jaypeeds/hamon-cam-1953/STL/bouchon.stl

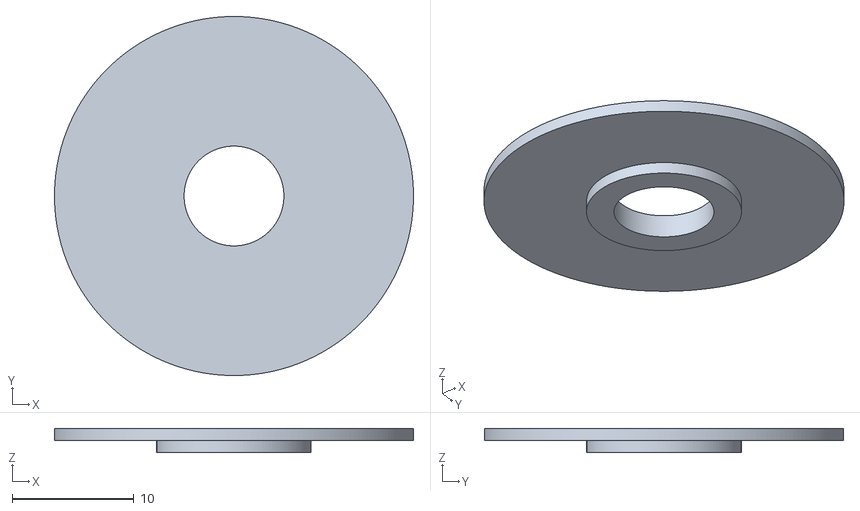
[picture p7: CAD file, 2019-05-12]
STL/bouchon.stl
29.5 x 29.5 x 2.00
