jaypeeds/hamon-cam-1953/STL/capot.stl

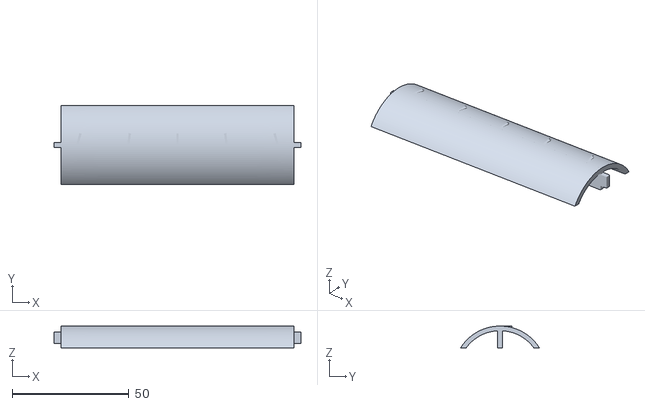
[picture p8: CAD file, 2019-05-12]
STL/capot.stl
106.0 x 33.9 x 9.39
