jaypeeds/hamon-cam-1953/STL/bras.stl

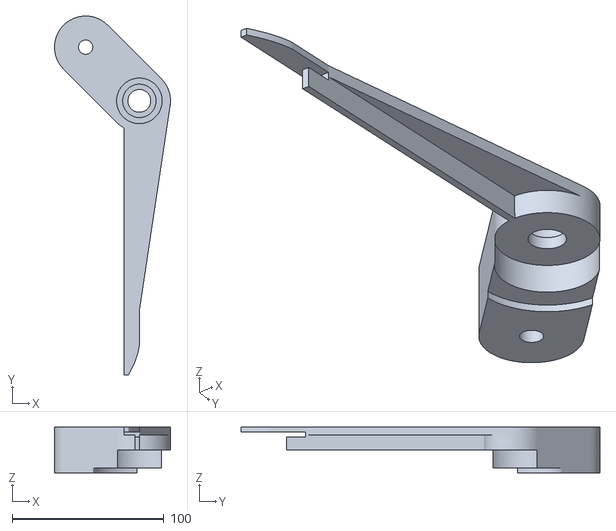
[picture p9: CAD file, 2019-05-12]
STL/bras.stl
76.4 x 236.3 x 30.0
