jaypeeds/hamon-cam-1953/STL/palier.stl

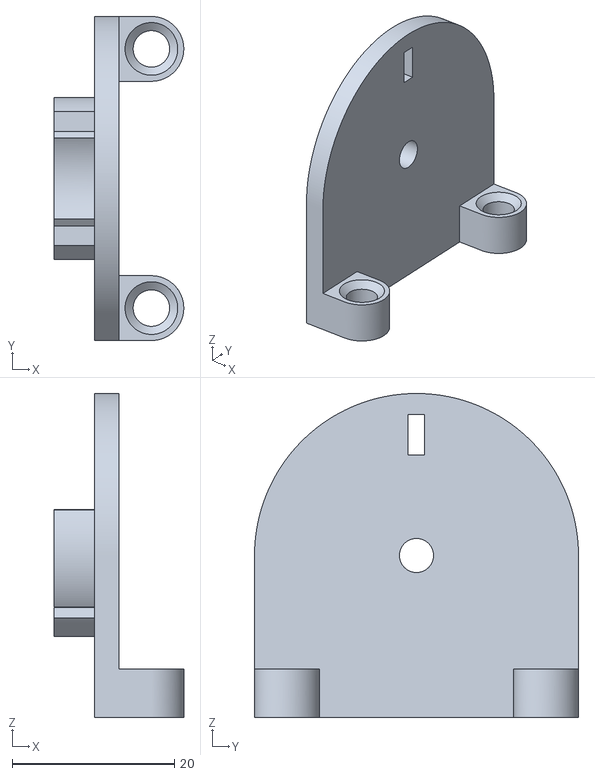
[picture p10: CAD file, 2019-05-12]
STL/palier.stl
16.0 x 40.0 x 40.0
