jaypeeds/hamon-cam-1953/STL/rail.stl

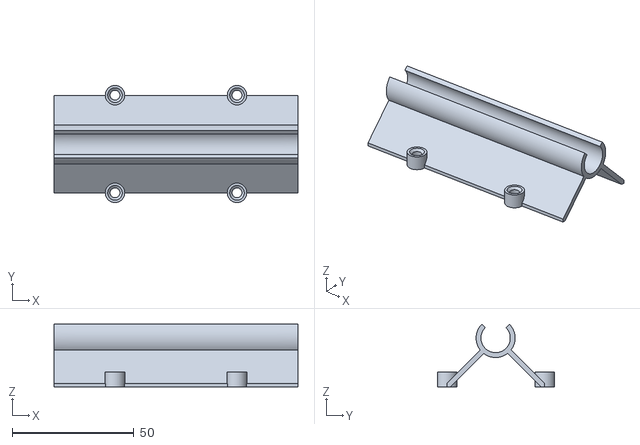
[picture p11: CAD file, 2019-05-12]
STL/rail.stl
100.0 x 48.0 x 25.7
