jaypeeds/hamon-cam-1953/STL/came.stl

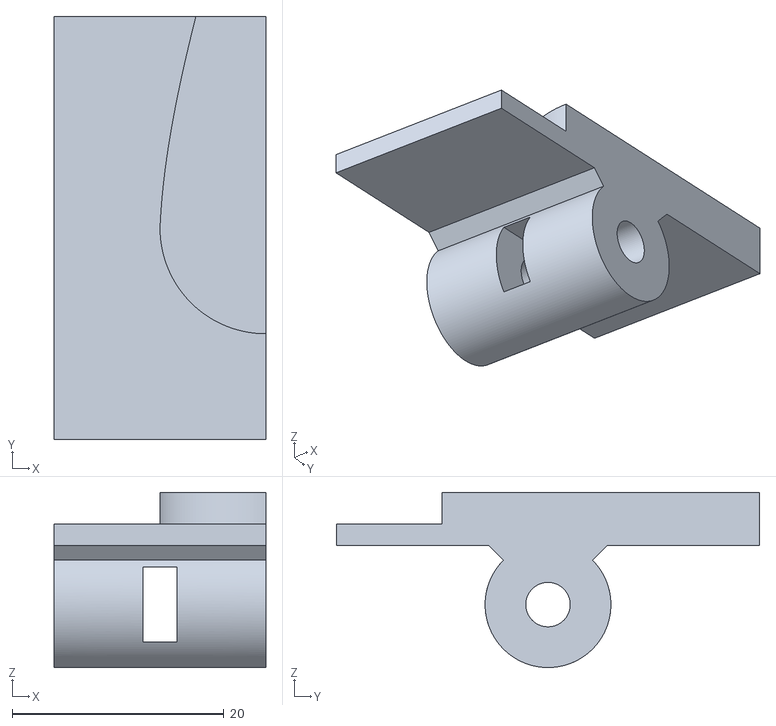
[picture p12: CAD file, 2019-05-12]
STL/came.stl
20.0 x 40.0 x 16.6
