jaypeeds/hamon-cam-1953/STL/embase-axe.stl

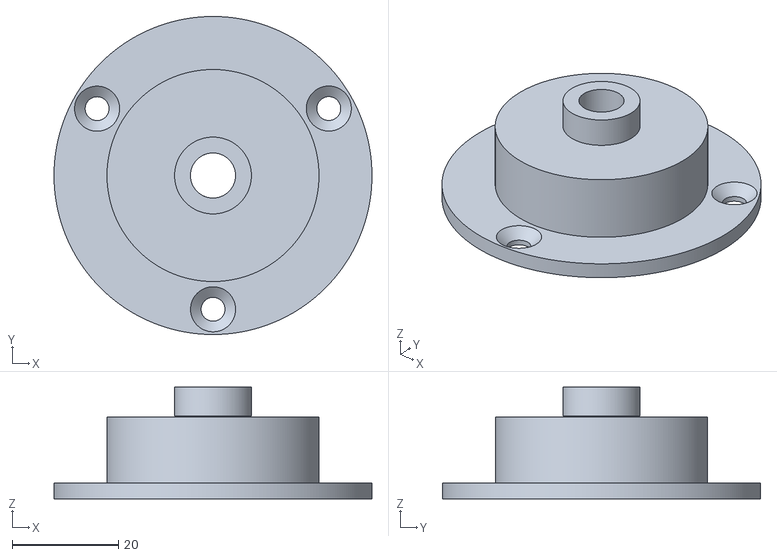
[picture p13: CAD file, 2019-05-12]
STL/embase-axe.stl
60.0 x 60.0 x 21.1
