jaypeeds/hamon-cam-1953/STL/support-moteur.stl

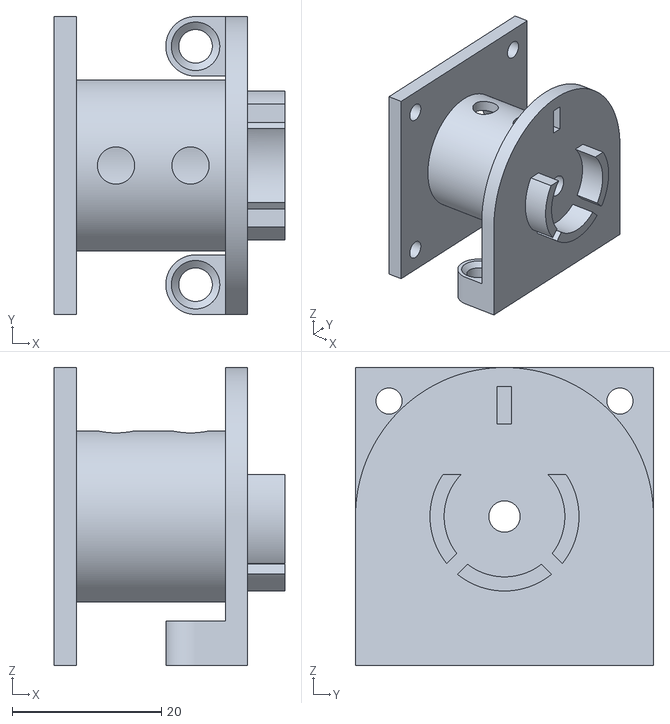
[picture p14: CAD file, 2019-05-12]
STL/support-moteur.stl
31.0 x 40.0 x 40.0
