jaypeeds/hamon-cam-1953/images/assembly and sketches.png

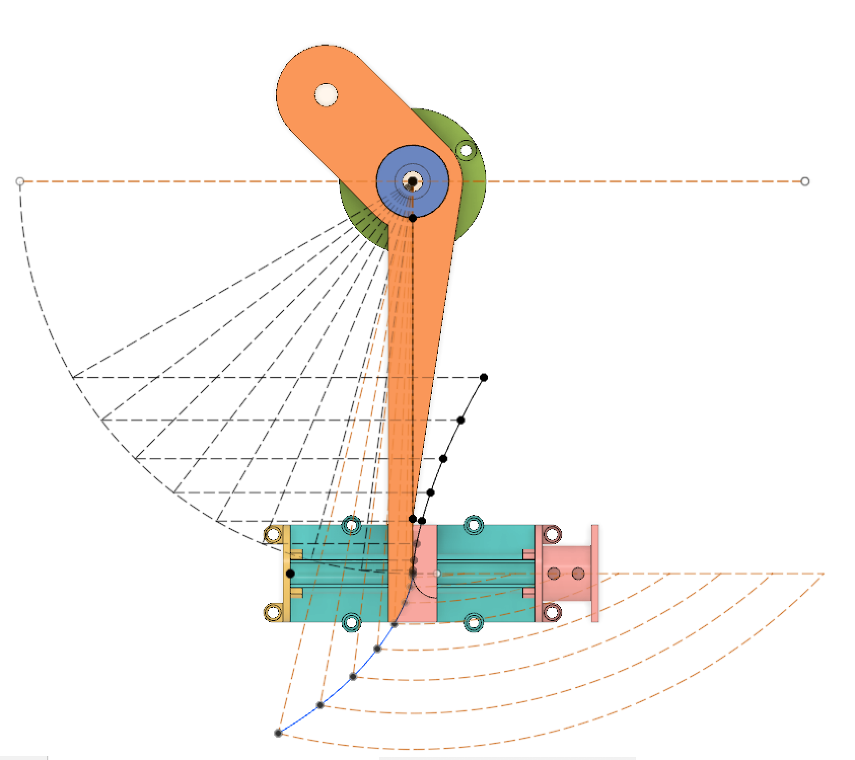
images/assembly and sketches.png
